anjula544/2DOF-Dyanamic-Positioning-Spoon/repot_images/download.jpg

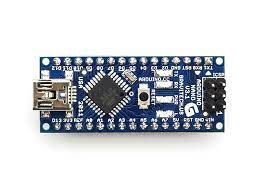
repot_images/download.jpg
