anjula544/2DOF-Dyanamic-Positioning-Spoon/repot_images/download (3).jpg

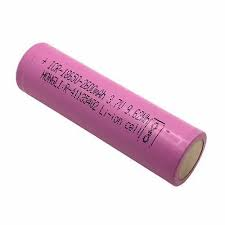
repot_images/download (3).jpg
