anjula544/2DOF-Dyanamic-Positioning-Spoon/README.md

# 2DOF Dyanamic Positioning Spoon

This repo presents an advanced sensor-based predictive modeling approach for dynamic spoon positioning and Parkinson’s disease stage prediction.

Youtube link about the project-https://youtu.be/nN2Vq60I2nY?si=y7R7AeB1s049sG_8
