anjula544/2DOF-Dyanamic-Positioning-Spoon/Reports/IEEE_IES_Generative_AI_challenge_final_submission (6).pdf

# Dynamic Spoon Positioning for Parkinson’s Patients and Disease Stage Prediction

D. A. A. de Silva
Department of Electrical and Electronics Engineering
Faculty of Engineering
University of Peradeniya
Peradeniya, Sri Lanka
e19065@eng.pdn.ac.lk
W. R. A. Fernando
Department of Electrical and Electronics Engineering
Faculty of Engineering
University of Peradeniya
Peradeniya, Sri Lanka
e19110@eng.pdn.ac.lk
H. H. Weerasinghe
Department of Electrical and Electronics Engineering
Faculty of Engineering
University of Peradeniya
Peradeniya, Sri Lanka
e19425@eng.pdn.ac.lk

Abstract—This work presents an advanced sensor-based predictive modeling approach for dynamic spoon positioning and Parkinson’s disease stage prediction. Parkinson’s disease is a progressive disorder that affects the nervous system and the parts of the body controlled by the nerves. This affects motor function causing tremors, rigidity and slowness of movements and impact day to day activities such as eating. Traditionally, Parkinson disease depend on clinical evaluation which have to be done frequently. Our dynamic spoon not only stabilize the food but also monitoring patient condition. This project proposes modern method to stabilize smart spoon using not only sensor input but also machine learning technique to increase the stability. Furthermore, machine learning techniques are used to train predictive models capable of accurately predicting spoon positioning and Parkinson’s disease stage. This design aims to provide real time feedback to the guardian or Doctor, accessing early detection of Parkinson disease and monitoring progression and stages. This improves patients’ quality of life and healthcare outcomes. Index Terms—self-stabilizing, Machine learning techniques, Real-time feedback

I. INTRODUCTION
Parkinson’s disease (PD) is a progressive neurological disorder that affects movement. It is characterized by symptoms such as tremors, stiffness, bradykinesia (slowness of movement), and postural instability. While Parkinson’s is often associated with older individuals, it can affect people of all ages, with only a small percentage diagnosed before the age of 50. [1] According to statistics, approximately 4% of all cases occur in individuals under the age of 50, making it more prevalent in older populations. As the second most age-related nerve degeneration disorder after Alzheimer’s, Parkinson’s poses significant challenges to individuals and their guardians.

The prevalence of Parkinson’s disease increases with age, with the majority of cases diagnosed in individuals over 60 years old. However, it’s important to note that PD can also affect younger individuals, albeit less frequently. The impact of Parkinson’s on daily life can be unpleasant, affecting various aspects of functioning, including mobility, communication, and independence. With the aging population worldwide, the burden of Parkinson’s disease is expected to rise, necessitating innovative solutions to improve the quality of life for affected individuals.

One of the primary challenges faced by individuals with Parkinson’s disease is the lack of fine motor skills, particularly during activities such as eating. Tremors and slowness of motion can make it difficult to control utensils and perform basic tasks independently. While assistive devices like self-stabilizing spoons exist, they may not fully address the needs of Parkinson’s patients. Additionally, the high cost of existing solutions limits accessibility for many individuals, highlighting the need for more affordable and effective alternatives.

The development of a dynamic spoon positioning system aims to enhance the quality of life for individuals living with Parkinson’s disease. By providing a solution that effectively addresses the challenges of tremors and motor impairments while eating, this innovative technology can empower patients to regain independence and dignity in their daily lives. With improved ability to feed themselves without assistance, Parkinson’s patients can experience greater independence and confidence, leading to enhanced overall well-being.

Self-stabilizing spoons equipped with servo motors represent a significant advancement in assistive technology for Parkinson’s patients. These spoons utilize sensors to detect hand tremors and adjust spoon position in real-time, allowing for more controlled and efficient eating movements. However, there is still room for improvement in optimizing the performance of these devices to better meet the individualized needs of users. Integrating machine learning models into the spoon’s functionality offers the potential to predict the progression of Parkinson’s disease stages and adjust the spoon’s stabilization mechanism accordingly.

Machine learning algorithms can analyze sensor data collected from the spoon while eating to identify patterns indicative of Parkinson’s disease progression. By monitoring changes in motor symptoms over time, the system can predict the stage of the disease and adapt the spoon’s positioning to accommodate evolving needs. This personalized approach ensures that individuals receive optimal support tailored to their specific condition, enhancing the effectiveness of the assistive device in improving eating experiences for Parkinson’s patients. Not only predict the stage but also monitor the progress after taking medicine.
By incorporating predictive modeling into the dynamic spoon positioning system, we can revolutionize the way Parkinson’s disease is managed and treated. Not only does this technology provide real-time assistance while eating, but it also offers valuable insights into disease progression, allowing for practical Solutions and personalized care strategies. By empowering individuals with Parkinson’s disease to maintain independence and Self-respect in their daily activities, this innovative solution has the potential to significantly enhance their quality of life and well-being.
The development of a dynamic spoon positioning system represents a Favorable step forward in the management of Parkinson’s disease. By combining sensor technology, servo motors, and machine learning algorithms, this innovative solution offers personalized support to individuals with tremors and motor impairments, enabling them to eat more comfortably and independently. With the potential to predict disease progression and adapt in real-time, the dynamic spoon positioning system holds great promise for improving the lives of Parkinson’s patients and their guardians. One such feature is the inclusion of an alert system that triggers in the event of a malfunction or if the patient stops responding. If the spoon drops or encounters an issue, it will automatically send a notification to the guardian, ensuring assistance and intervention when needed. This proactive approach not only improves safety but also provides reassurance to patients and their loved ones, allowing them to confidently rely on the technology for daily support.
In the end, a method is to be innovated to stabilize the spoon even in the presence of tremors, ensuring that the food remains stable. An IoT system is to be built to remotely monitor patient conditions while eating. Additionally, the prediction of Parkinson’s disease stages should be possible.

II. SYSTEM IMPLEMENTATION
A. Overall view of the System

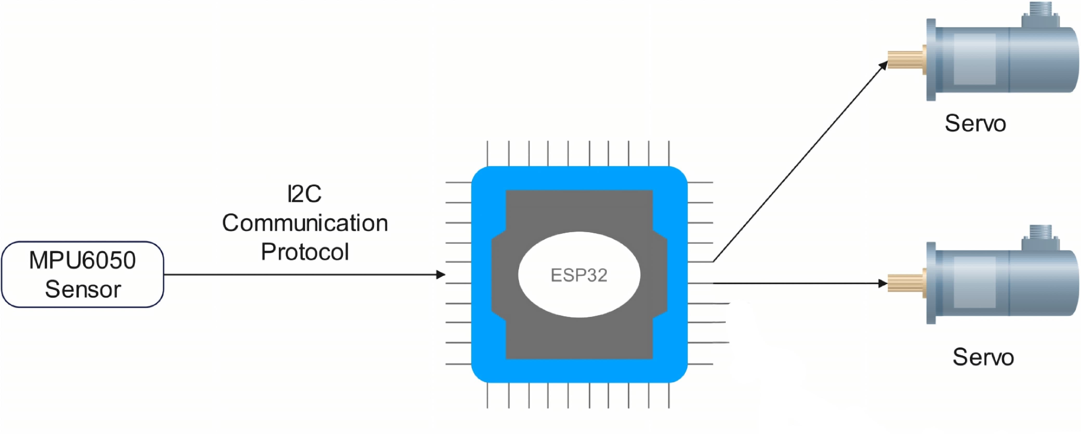
[picture p17: figure]

Fig. 1. System Outline

The system comprises an MPU6050 sensor, which includes an accelerometer and gyroscope, designed to detect hand movements indicative of Parkinson’s disease and track orientation relative to gravity. An Atmega328P serves as the microcontroller for processing data and making decisions, subsequently transmitting the information to two servo motors. Illustrated in the above figure, the project’s operational concept initiates with input from the MPU6050 sensor, which reads data upon tilting. This data is then forwarded for processing by the microcontroller, directing the servo motors to stabilize the assistive device, thereby functioning as its output.

B. Basic Working Principle

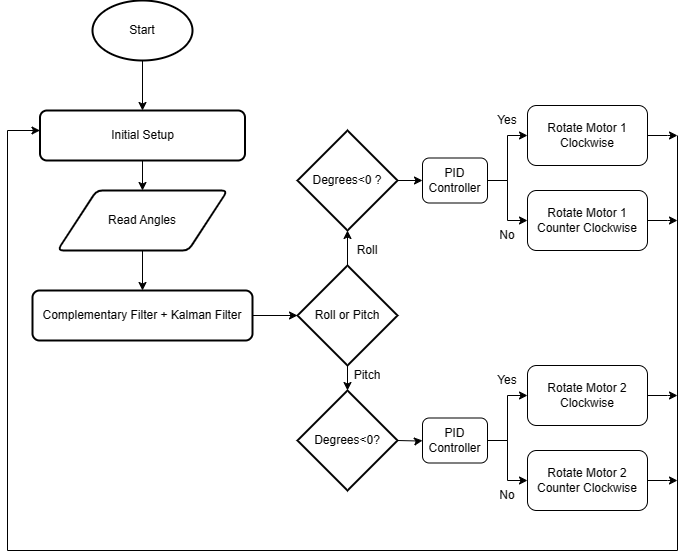
[picture p18: figure]

Fig. 2. Functionality of the system

With regard to the diagram above, the system’s functionality can be outlined as follows. Initially, the system undergoes an initial setup phase before repetitively reading angle values. These values are then processed through complementary and Kalman filters to reduce noise and fuse data. The filtered angle data is then analyzed to discern whether it indicates a roll or pitch movement. Based on this information, the system determines the direction of motion, whether it is left or right, upward or downward. Depending on the type of movement and the magnitude of the angle value, the system decides to rotate either Motor 1 or Motor 2 clockwise or counterclockwise, ensuring that the spoon remains horizontal at all times. Without a PID controller, the spoon may struggle to effectively regulate its output to achieve the horizontal set point. To avoid these scenarios, PID controllers are used for both the X and Y axes.

C. Equations

The PID control formula:

PID(t) = Kp · e(t) + Ki

·

Z t

0

e(τ )dτ + Kd ·

de(t)
dt (1)

where:

Kp: Proportional gain,
Ki
: Integral gain,
Kd: Derivative gain,
e(t): Error at time t,
Z t

0

e(τ )dτ : Integral of the error from 0 to t,

de(t)
dt : Derivative of the error with respect to time.

The Kalman filter formulas:

xˆk|k−1 = Fkxˆk−1|k−1 + Bkuk | (2)

Pk|k−1 = FkPk−1|k−1F

T
k + Qk | (3)

The update step of the Kalman filter is given by:

Kk = Pk|k−1HT k

(HkPk|k−1HT
k + Rk)
−1 | (4)
xˆk|k = ˆxk|k−1 + Kk(zk − Hkxˆk|k−1) | (5)
Pk|k = (I − KkHk)Pk|k−1 | (6)

Where:
- xˆk|k−1 is the predicted state estimate at time k given measurements up to time k − 1.
- Pk|k−1 is the predicted state covariance at time k given measurements up to time k − 1.
- Fk is the state transition model matrix for time step k.
- Bk is the control input model matrix for time step k.
- uk is the control input at time step k.
- Qk is the covariance matrix for the process noise at time step k.
- Kk is the Kalman gain at time step k.
- Hk is the measurement model matrix for time step k.
- Rk is the covariance matrix for the measurement noise at time step k.
- xˆk|k is the updated state estimate at time k given measurements up to time k.
- zk is the measurement at time step k.
- I is the identity matrix.
The complementary filter formula:
θcomp(t) = α · θgyro(t) + (1 − α) · θacc(t) | (7)

where:
- θcomp(t) is the estimated orientation at time t using the complementary filter.
- θgyro(t) is the orientation estimate from the gyroscope at time t.
- θacc(t) is the orientation estimate from the accelerometer at time t.
- α is the filter coefficient, usually chosen between 0 and 1 to control the contribution of each sensor. Typically, α is close to 1 to give more weight to the gyroscope data, as it is less affected by noise in short-term changes, while accelerometer data is used for long-term stability correction.
D. Hardware Setup
The prototype, designed using SolidWorks, employs two servo motors for 2-axis control movement. It incorporates an MPU6050 sensor, an Arduino Nano, a TP4056 charging module, and an 18650 battery for power.

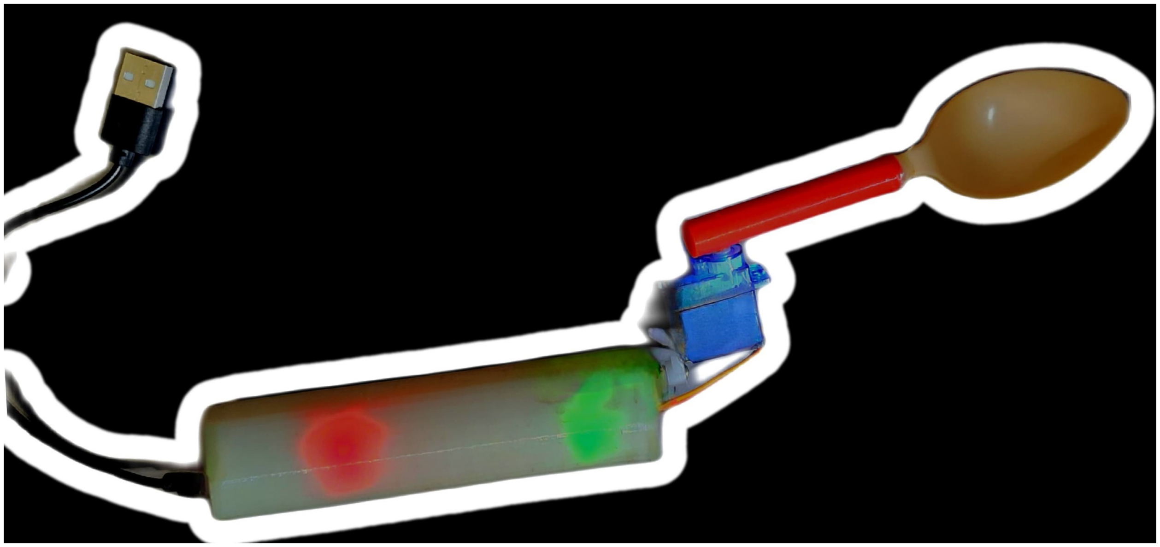
[picture p19: figure]

Fig. 3. Hardware implementation of the system

In assembling the prototype, acrylic was chosen for the housing and support due to its availability and affordability. Servo motor supports were attached to the housing using screws, repeated for the two servo motors utilized in the project.
To ensure wire organization, holes were created beside the housing for servo wires to enter, connecting to pins on the Arduino Nano. Details regarding servo motor connections will be provided later. Powering the project is facilitated by an 18650 battery positioned within the housing.

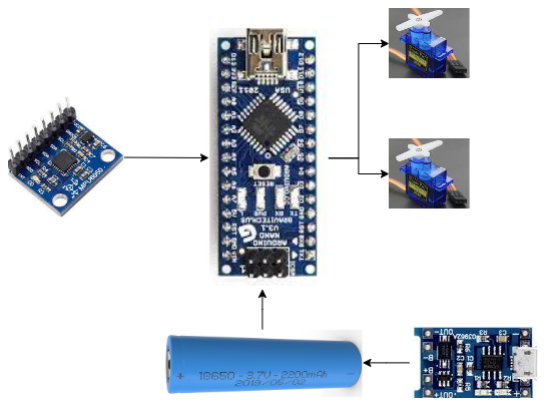
[picture p20: figure]

Fig. 4. Circuit Diagram of the System


Fig. 5. 3D Model Of the System

The servo motor connections involve linking the signal wires of the servo motors to pins 8 and 9 on the Arduino Nano, while ensuring appropriate power and ground connections to the Arduino Nano or an external power supply.

Concurrently, for the MPU6050 sensor, the SDA (Serial Data) pin is connected to pin A4, and the SCL (Serial Clock) pin is connected to pin A5 on the Arduino Nano. Additionally, the VCC (Power) pin of the MPU6050 sensor is linked to the 5V pin on the Arduino Nano or an external power source, and the GND (Ground) pin is connected to the ground (GND) pin on the Arduino Nano or a shared ground within the system. These connections establish the communication and power supply necessary for the proper functioning of the servo motors and MPU6050 sensor within the prototype

III. WORKING OF THE SYSTEM WITH GENERATIVE AI


Fig. 6. System Outline with Machine Learning Algorithms

The basic functionality of the system was elaborated under section III. It was noted, during the development process, that the positioning of the spoon can be significantly improved with the use of Artificial Intelligence. Hence, the following approach was followed.
Initially, tremor data was collected from two Parkinson’s patients—one with a mild case of the disease and the other with a severe case. Both patients were above 60 years old. The collected data consisted of accelerometer and gyroscope data. Using that data, a model was trained to detect the severity level of the patient holding the device. Once the model was trained, two approaches were available. First, the data read from the microcontroller was to be sent to the model and the response be sent via IoT. Since rapid response is a requirement of the device, that approach was discarded. The second approach was to deploy the model on the microcontroller itself. In this case, the trained model was converted to one that can be run on an ESP32 with the use of TensorFlow Lite. A PID controller was then implemented to stabilize the movement of the spoon. The values for the PID controller constant were chosen depending on the patient’s severity level recognized by the model. However, this approach was proven to be erroneous as well. Particularly, the model had not been trained well due to not having a large enough dataset.

The machine learning models SVM (Support Vector Machine), SVC (Support Vector Classifier), and CNN (Convolutional Neural Network) were developed and trained for Parkinson’s stage classification using the Python programming language. However, significantly accurate results could not be achieved due to the limited availability of data to overcome the issue of data availability, synthetic data is generated using CTGAN and evaluated using the TableEvaluator, but the expected output is not significantly developed.
The following approach was finally adopted. While observing the datasets from the patients, the following pattern was observed: When the tremor levels are more severe, the sign changes in accelerometer values are more frequent. Conversely, when the severity level decreases, sign changes become less frequent. Since accurate output couldn’t be obtained using the previously explained machine learning model due to a lack of data, we chose to focus on the rate of sign changes, which resulted in successful outcomes. To achieve this goal, the code was adapted to allow the microcontroller to handle the task itself. Following this adjustment, improvements in stabilizing the spoon based on changes in severity level could be observed.

TABLE I
PID VALUES CORRESPONDING TO DIFFERENT OPERATING MODES
Operating Mode | Axis | Parkinson Stage | Kp | Ki | Kd
2*Basic Operation Mode | X Y | No classification method No classification method | 1.05 1.1 | 0 0 | 0 0
4*With Integrating ML | X Y | Low High Low High | 1 1.1 1 1.2 | 0 0 0 0 | 0 0 0 0
4*With Considering Accel. Change | X Y | Low High Low High | 1.02 1.15 1 1.2 | 0 0 0 0 | 0 0 0 0

The following figure represents accelerator and gyroscope data of severe Parkinson’s patients.

TABLE II
ACCELEROMETER AND GYROSCOPE VALUES OF SEVERE PARKINSON’S

PATIENT

Time | AccX | AccY | AccZ | GyroX | GyroY | GyroZ
0.74327831 0.743297836 0.743298924 0.743300556 0.743301632 0.743303264 0.743304352 0.743305972 0.74330706 0.743308692 0.743310313 0.7433114 0.743313032 0.743314109 0.743315741 0.743316829 0.743318449 0.743319537 0.743321169 0.743322245 | 5860 1988 -332 -3236 488 488 -1232 -1912 -9248 -12080 -7992 -2496 3864 7724 10492 3072 2708 2108 -6684 -7904 | 2764 -4244 -4840 -9612 -3364 -4112 -7508 -7060 -16740 -19240 -12492 -5284 2276 10048 16180 8756 2264 1612 -10016 -11748 | 19852 21744 13376 7960 14576 13840 11388 15476 3976 5736 5884 15560 15660 22620 24644 15704 13136 12380 12360 16132 | -1216 -1200 -1232 -1200 -1200 -1200 -1232 -1232 -1200 -1216 -1216 -1216 -1216 -1248 -1216 -1248 -1216 -1216 -1248 -1232 | 12444 6995 1203 -412 -514 -641 499 -1063 409 -1432 -114 -656 -785 -302 -804 1195 845 -1295 -966 -916 | 3929 6911 127 2135 -1605 -1064 685 495 -8034 -1747 3208 5211 6188 4522 9362 11442 6386 5660 2604 -1113

The accelerations and gyroscope readings obtained by the sensor are continuously stored in the Excel file. From this data, more synthetic data is generated .The synthetic data generation process involves utilizing the Conditional Tabular GAN

TABLE III
SYNTHETICALLY GENERATED ACCELEROMETER AND GYROSCOPE

VALUES WITH STATUS

AccX | AccY | AccZ | GyroX | GyroY | GyroZ | Status
-2784 -752 1328 -3412 -4092 -3628 -3556 -1724 -1092 1388 -644 1092 11936 -1440 -196 -928 -1184 | 7968 7132 8716 -796 -404 8636 6956 176 8900 12492 2380 -10016 7652 6672 5548 7228 8700 | 16656 13968 15740 6260 17900 16812 -13656 16296 19016 -44 5228 17096 6724 17924 14148 17620 17240 | -1008 -960 -1056 -1216 -1216 -976 -1008 -1216 -1024 -1024 -960 -1008 -1024 -1024 -1024 -960 -992 | 330 2190 -2455 10974 -2942 -575 606 1069 1120 495 -5984 105 378 -979 480 -516 641 | -570 124 -2136 -4703 3292 -285 968 448 763 -1179 395 753 -691 536 8244 -709 693 | high low high high high mid high high low low high high mid mid high high high

(CTGAN) model to generate data that closely resembles the original dataset, which comprises accelerometer and gyroscope values along with Parkinson’s stage labels. CTGAN builds depend on a generative adversarial network (GAN) framework, where a generator network learns to generate samples that are indistinguishable from the real data. In contrast, a discriminator network learns to distinguish between real and synthetic samples. During training, the generator aims to minimize the difference between the distributions of the synthetic and real data, guided by feedback from the discriminator. This adversarial training process continues iteratively until the generator produces synthetic samples that closely match the statistical properties and distributions of the original dataset. Following training, the CTGAN model generates synthetic samples by sampling from the learned generator network. These generated samples are then evaluated through visual inspection, statistical analysis, and comparison with the original dataset to ensure they capture the essential characteristics and distributions of the real data. Additionally, the original and synthetic datasets undergo preprocessing steps, like data cleaning, scaling, and encoding of categorical variables, to prepare them for input into the Parkinson’s stage prediction algorithm.
The total operating time of the spoon was detected using a generative AI-trained model. At the end of the day, a report was generated, which included the starting and ending operating times, as well as the total operating time of the spoon.

Fig. 7. Graphical user interface window displaying the usage time of a spoon

IV. RESULTS

According to sections II and III, the dynamic spoon is positioned by countering movements along the X and Y axes. Now, it is necessary to estimate the stability level. For this purpose, another MPU6050 sensor is placed on the spoon and connected to a separate Uno board. Subsequently, the output is plotted when the spoon experiences tremors. Simultaneously, the serial plot from the Nano board of the spoon is obtained. The two plots are then compared to evaluate their respective characteristics and performance. The following figure shows the testing setup.

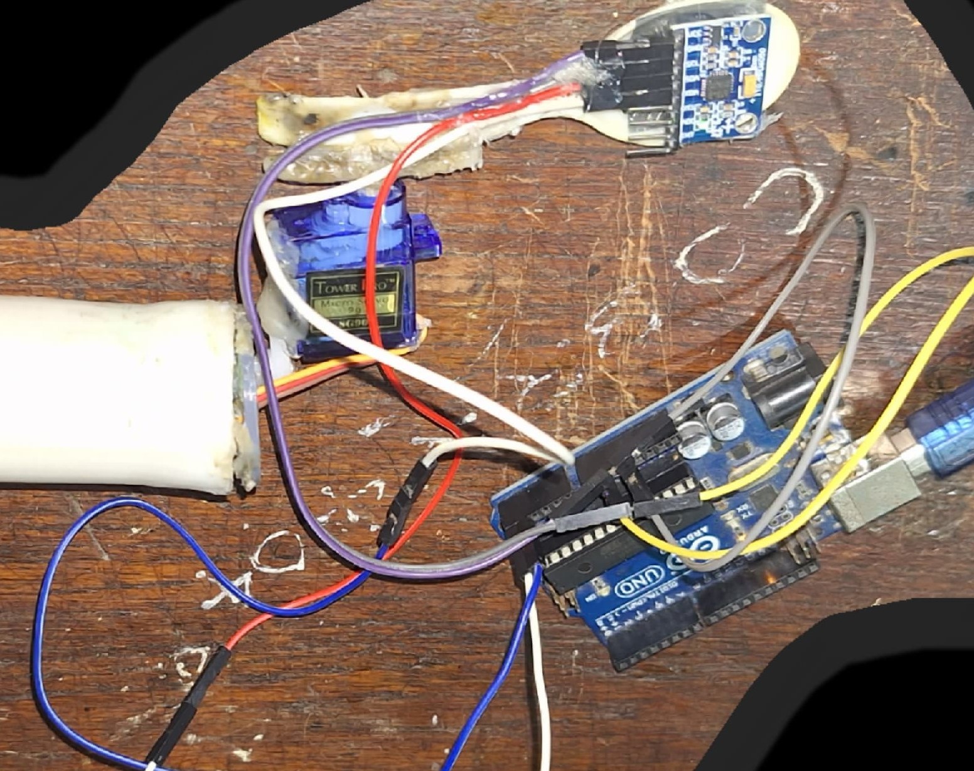
[picture p21: figure]

Fig. 8. Testing Setup

Figure 11 showcases the results without the ML model. The upper half of the Figure shows the graph of data from the sensor on the spoon, while the lower graph illustrates the tremors experienced by the spoon.

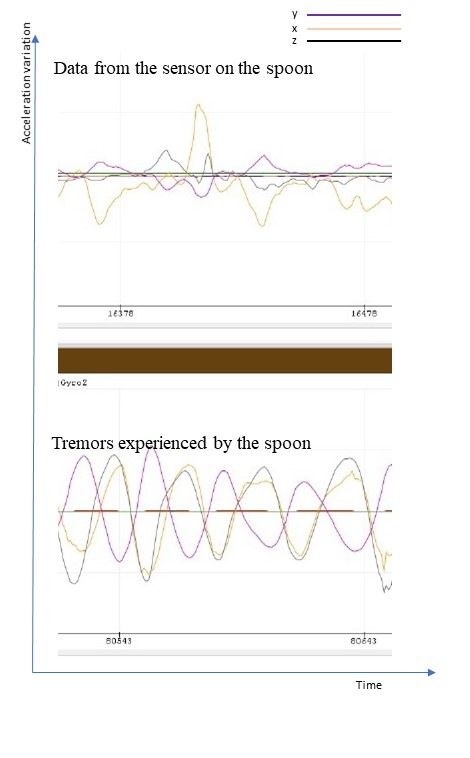
[picture p22: figure]

Fig. 9. Results Without ML model

As a solution to the case shown in Figure 9, a Machine Learning Model was implemented. However, the results did not show significant improvement as sufficient data was not available to properly train the model. Additionally, some inaccuracies were observed in the data as well. Although there was a slight improvement in the results, it was minimal. Figure 10 displays results obtained with the ML model.

Then, another method called direction changes was approached. In this method, rapid changes in hand acceleration direction occur during high tremors. By analyzing the acceleration direction changes, we were able to predict the stages and provide feedback to the system. Figure 11 graph illustrates the results of the direction changes method.

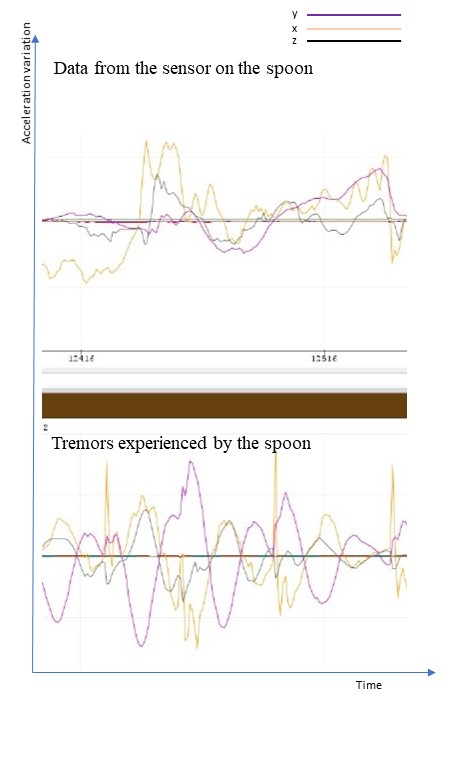
[picture p23: figure]

Fig. 10. Results With ML model

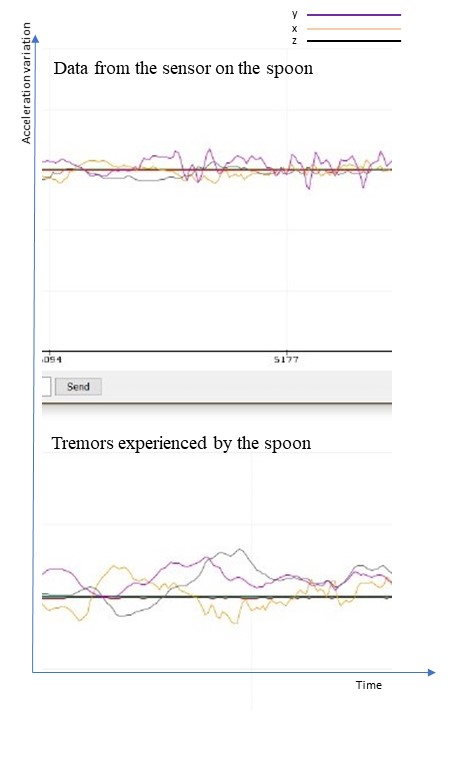
[picture p24: figure]

Fig. 11. Results with Direction change method

Even if the Direction Change method seems to be more accurate, the ML model may have given better results if it were well-trained with enough data.
Furthermore, a generative AI method is utilized to detect the stages of Parkinson’s patients. Since data collected from patients were insufficient, synthetic data were generated. The collected data were categorized into low, mid, and high tremors, which were then fed into the machine learning system. Now, when the spoon is in use, the machine learning model receives sensor data and analyzes it over a certain time period to determine the stage as low, mid, or high. This approach can be further developed for stage prediction and monitoring the progress of taking medicine.

REFERENCES

[1] S. Virameteekul, O. Phokaewvarangkul, and R. Bhidayasiri, “Profiling the most elderly parkinson’s disease patients: Does age or disease duration matter?,” PLOS ONE, vol. 16, no. 12, p. e0261302, Dec. 2021, doi: https://doi.org/10.1371/journal.pone.0261302.
[2] “Liftware | - | Eat | with | confidence,” | www.liftware.com.
http://www.liftware.com
[3] “Site is undergoing maintenance,” Gyenno Technologies - Anti Tremor Parkinson Smart Spoon Gyenno Official Australian Website. http://www.gyenno.com.au/product/gyenno-bravo-twist (accessed Mar. 05, 2024).
[4] Zampogna A, Manoni A, Asci F, Liguori C, Irrera F, Suppa A. Shedding Light on Nocturnal Movements in Parkinson’s Disease: Evidence from Wearable Technologies. Sensors. 2020; 20(18):5171. https://doi.org/10.3390/s20185171
[5] McKay GN, Harrigan TP, Brasiˇ c JR. A low-cost quantitative ´ continuous measurement of movements in the extremities of
people | with | Parkinson’s | disease. | MethodsX. | 2019;6:169-189.
doi:https://doi.org/10.1016/j.mex.2018.12.017
[6] Zampogna A, Manoni A, Asci F, Liguori C, Irrera F, Suppa A. Shedding Light on Nocturnal Movements in Parkinson’s Disease: Evidence from Wearable Technologies. Sensors. 2020;20(18):5171. doi:https://doi.org/10.3390/s20185171
[7] Y. Yorozu, M. Hirano, K. Oka, and Y. Tagawa, “Electron spectroscopy studies on magneto-optical media and plastic substrate interface,” IEEE Transl. J. Magn. Japan, vol. 2, pp. 740–741, August 1987 [Digests 9th Annual Conf. Magnetics Japan, p. 301, 1982].
[8] Parkinson’s Disease Detection by Using Machine Learning Algorithms and Hand Movement Signal from LeapMotion Sensor — IEEE Conference Publication — IEEE Xplore. ieeexplore.ieee.org. Accessed March 5, 2024. https://ieeexplore.ieee.org/document/9087433
[9] San-Segundo R, Zhang A, Cebulla A, Panev S, Tabor G, Stebbins K, Massa RE, Whitford A, de la Torre F, Hodgins J. Parkinson’s Disease Tremor Detection in the Wild Using Wearable Accelerometers. Sensors. 2020; 20(20):5817. https://doi.org/10.3390/s20205817
[10] Hssayeni MD, Jimenez-Shahed J, Burack MA, Ghoraani B. Wearable Sensors for Estimation of Parkinsonian Tremor Severity
during | Free | Body | Movements. | Sensors. | 2019; | 19(19):4215.
https://doi.org/10.3390/s19194215
[11] Dixit S, Bohre K, Singh Y, Himeur Y, Mansoor W, Atalla S, Srinivasan K. A Comprehensive Review on AI-Enabled Models for Parkinson’s Disease Diagnosis. Electronics. 2023; 12(4):783. https://doi.org/10.3390/electronics12040783
