anjula544/2DOF-Dyanamic-Positioning-Spoon/repot_images/Firmware Outline.pptx

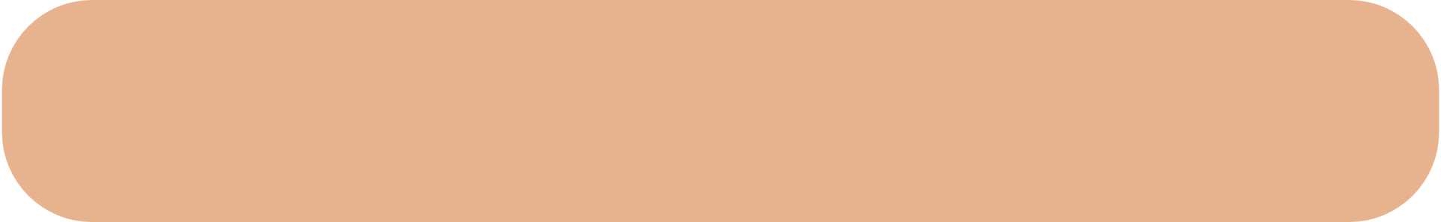
[picture p29: figure]

Firmware Outline

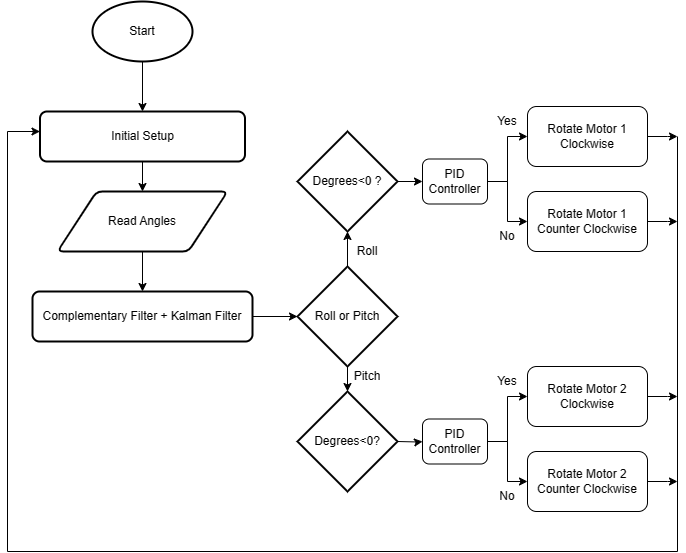
[picture p30: figure]
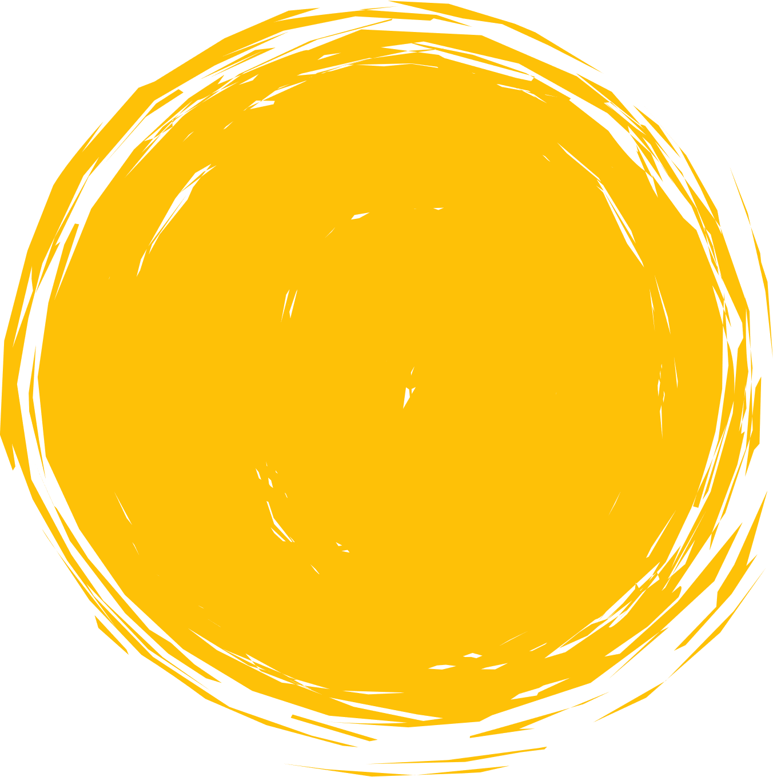
[picture p31: figure]
