anjula544/2DOF-Dyanamic-Positioning-Spoon/repot_images/6b85638a-87ed-41be-9f65-1bd7224a2d52.jpg

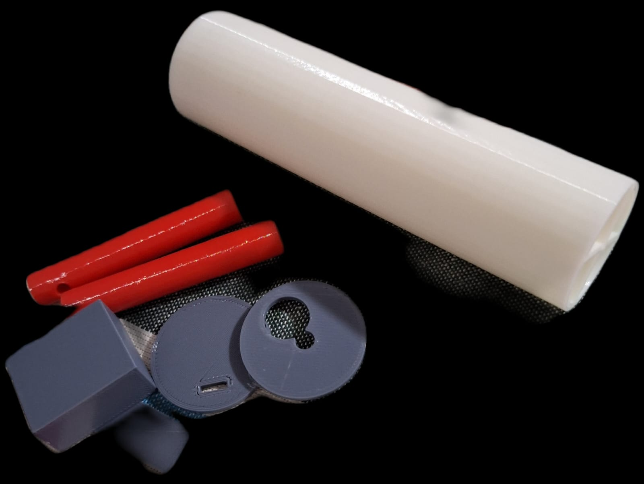
repot_images/6b85638a-87ed-41be-9f65-1bd7224a2d52.jpg
