anjula544/2DOF-Dyanamic-Positioning-Spoon/repot_images/Accelerometer-and-gyroscope-data.png

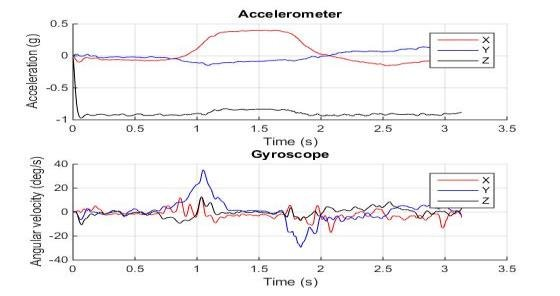
repot_images/Accelerometer-and-gyroscope-data.png
