anjula544/2DOF-Dyanamic-Positioning-Spoon/repot_images/aiimp.png

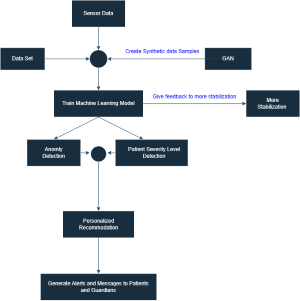
repot_images/aiimp.png
