anjula544/2DOF-Dyanamic-Positioning-Spoon/repot_images/breif.drawio.png

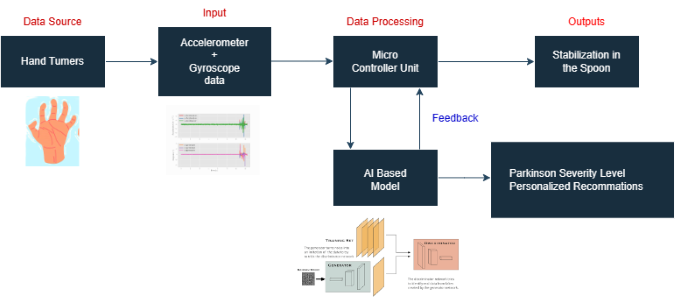
repot_images/breif.drawio.png
