anjula544/2DOF-Dyanamic-Positioning-Spoon/repot_images/download (2).jpg

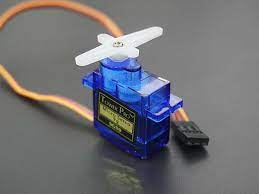
repot_images/download (2).jpg
