anjula544/2DOF-Dyanamic-Positioning-Spoon/repot_images/download (4).jpg

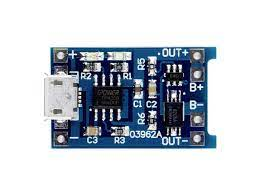
repot_images/download (4).jpg
