anjula544/2DOF-Dyanamic-Positioning-Spoon/repot_images/fig1.png

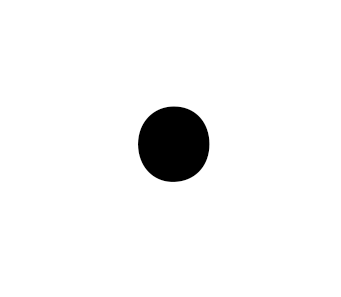
repot_images/fig1.png
