anjula544/2DOF-Dyanamic-Positioning-Spoon/repot_images/grpimg.jpg

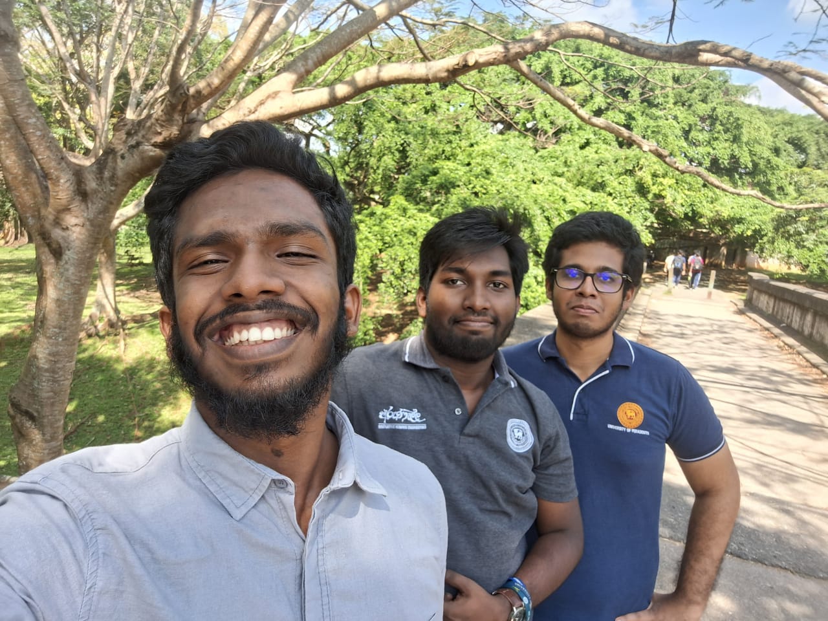
repot_images/grpimg.jpg
