anjula544/2DOF-Dyanamic-Positioning-Spoon/repot_images/hand.jpg

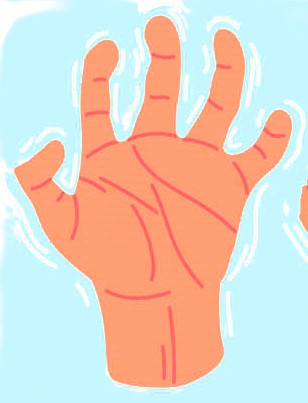
repot_images/hand.jpg
