anjula544/2DOF-Dyanamic-Positioning-Spoon/repot_images/istockphoto-1307564882-612x612.jpg

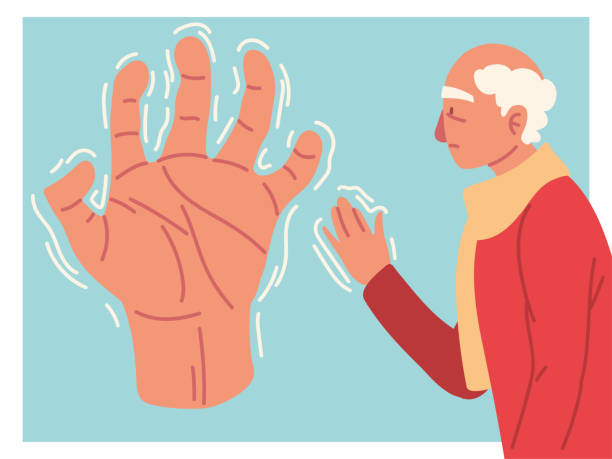
repot_images/istockphoto-1307564882-612x612.jpg
