anjula544/2DOF-Dyanamic-Positioning-Spoon/repot_images/li-ion-battery-18650-rechargeable-PxAAdlB-600.jpg

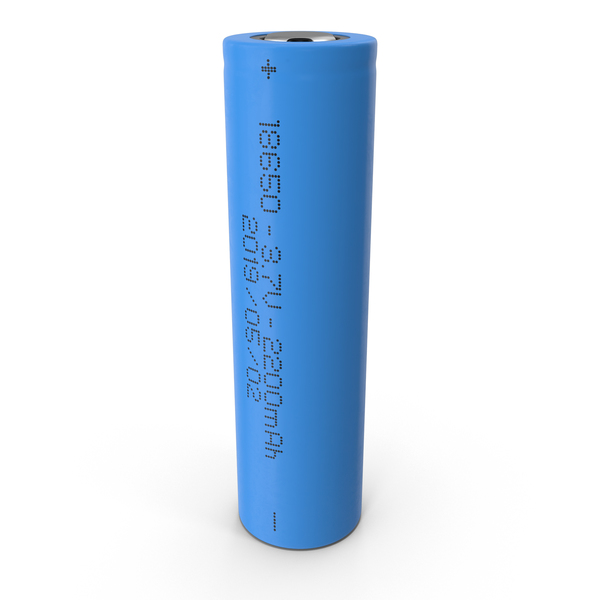
repot_images/li-ion-battery-18650-rechargeable-PxAAdlB-600.jpg
