anjula544/2DOF-Dyanamic-Positioning-Spoon/repot_images/PCB_PCB_5thSemPro_2024-04-12.png

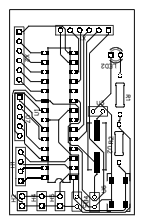
repot_images/PCB_PCB_5thSemPro_2024-04-12.png
