anjula544/2DOF-Dyanamic-Positioning-Spoon/repot_images/Schematic_5thSemPro_2024-04-12.png

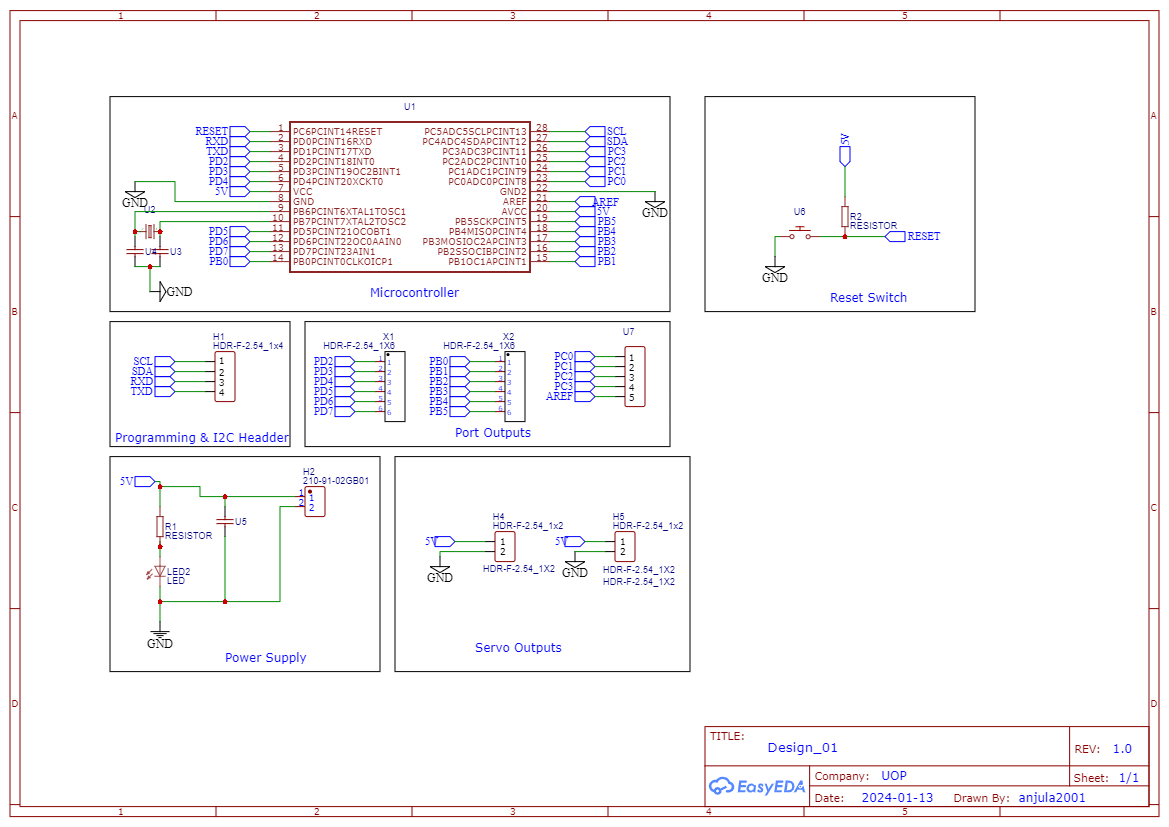
repot_images/Schematic_5thSemPro_2024-04-12.png
