anjula544/2DOF-Dyanamic-Positioning-Spoon/repot_images/Screenshot 2024-03-11 102949.png

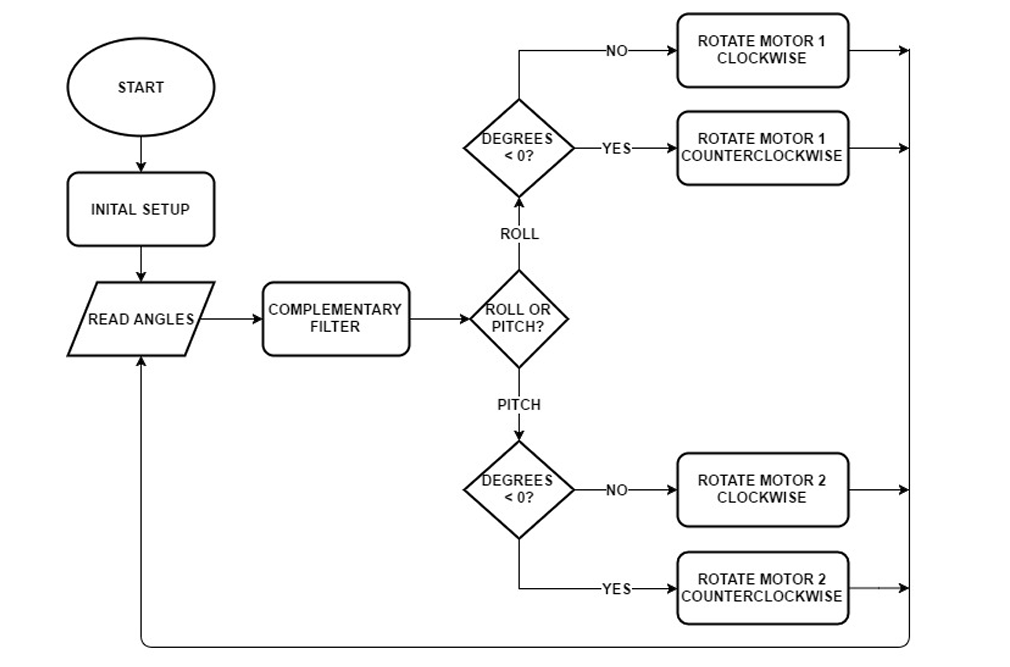
repot_images/Screenshot 2024-03-11 102949.png
