anjula544/2DOF-Dyanamic-Positioning-Spoon/Prototype1_3dPrint/Assem1.SLDASM

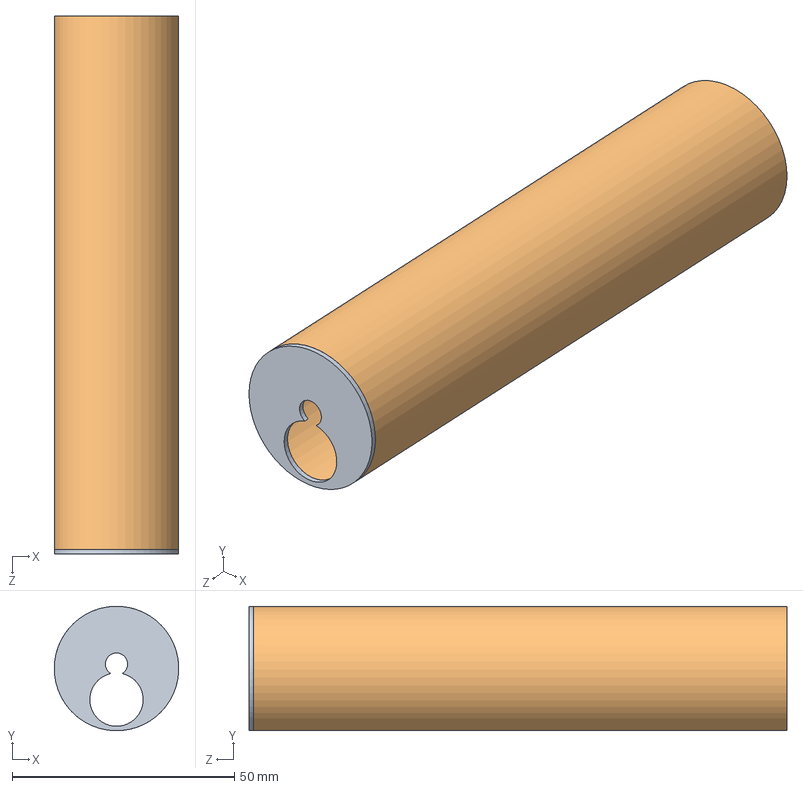
[picture p48: CAD file, 2024-06-04]
Prototype1_3dPrint/Assem1.SLDASM
28.0 x 28.0 x 121.0 mm
circ1
circ2
