anjula544/2DOF-Dyanamic-Positioning-Spoon/Prototype1_3dPrint/circ3.SLDPRT

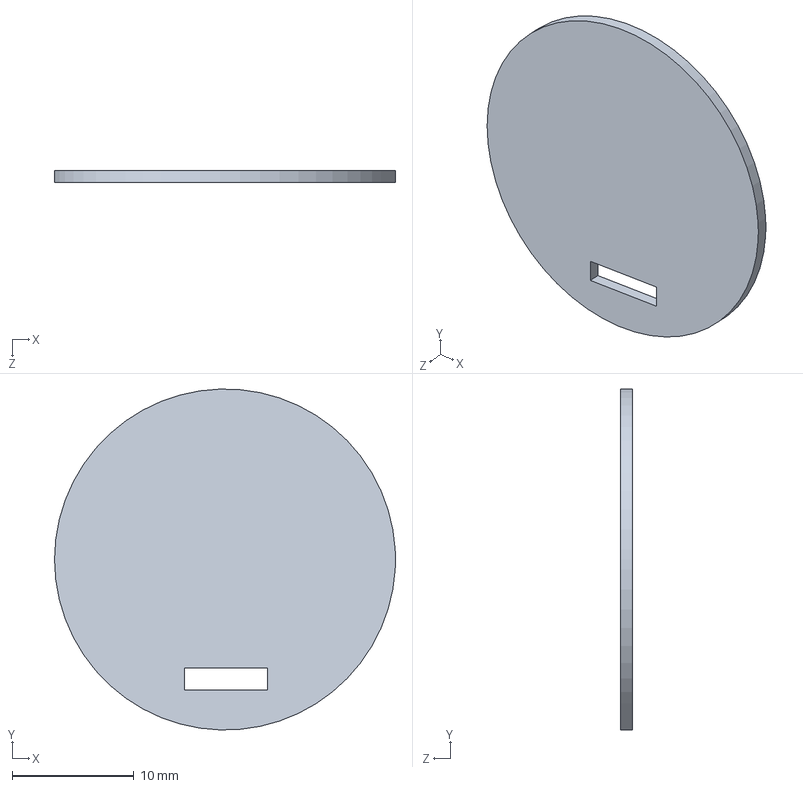
[picture p49: CAD file, 2024-06-04]
Prototype1_3dPrint/circ3.SLDPRT
28.0 x 28.0 x 1.00 mm
