anjula544/2DOF-Dyanamic-Positioning-Spoon/Prototype1_3dPrint/box2.SLDPRT

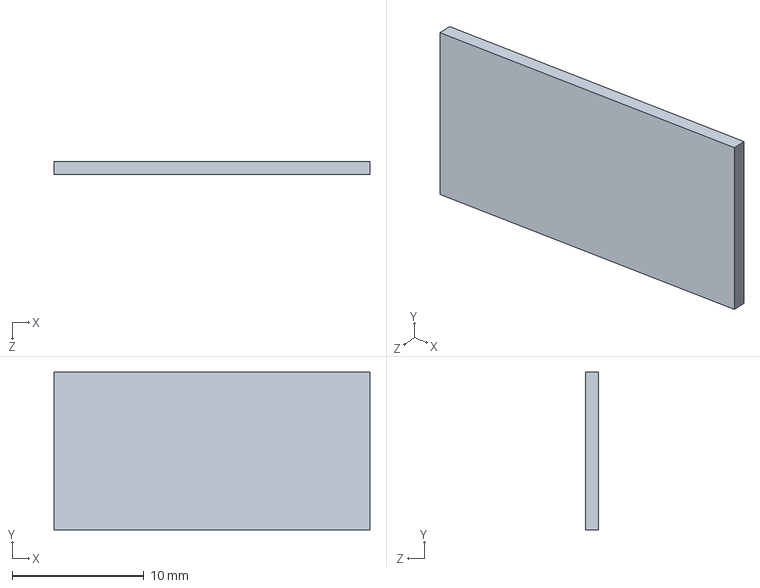
[picture p50: CAD file, 2024-06-04]
Prototype1_3dPrint/box2.SLDPRT
24.0 x 12.0 x 1.00 mm
