anjula544/2DOF-Dyanamic-Positioning-Spoon/Prototype1_3dPrint/box1.SLDPRT

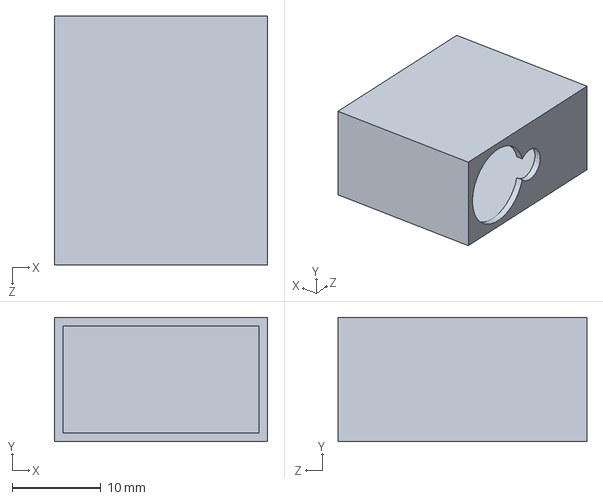
[picture p51: CAD file, 2024-06-04]
Prototype1_3dPrint/box1.SLDPRT
24.0 x 14.0 x 28.0 mm
