anjula544/2DOF-Dyanamic-Positioning-Spoon/Prototype1_3dPrint/spoon1.SLDPRT

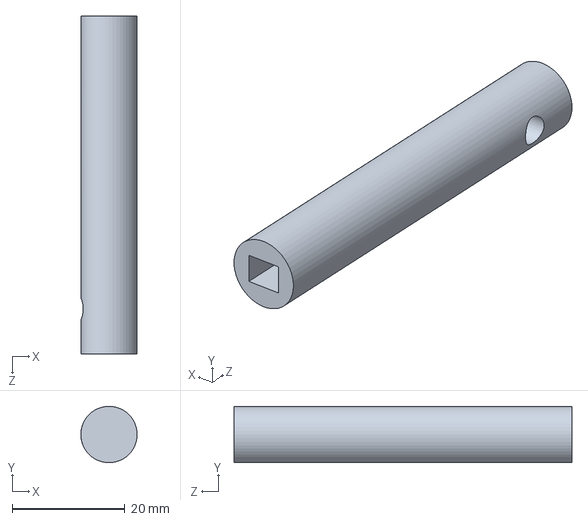
[picture p52: CAD file, 2024-06-04]
Prototype1_3dPrint/spoon1.SLDPRT
10.0 x 10.0 x 60.0 mm
