anjula544/2DOF-Dyanamic-Positioning-Spoon/(commit log)

2024-06-04 ML Implementation
    Codes for GAN,filtering and classification
2024-06-04 Stl files
    [Assem1.SLDASM, box1.SLDPRT, box2.SLDPRT, circ3.SLDPRT, spoon1.SLDPRT]
2024-06-04 Data files for ml implemntation
    [combined_data_1.xlsx, filtered_data (1).xlsx, generated_samples.xlsx, high.xlsx, low.xlsx, mid.xlsx]
